JihuiTanUchicago/pcb-for-robot/final_presentation_slides/final presentation.pdf

Youtube: https://youtu.be/oqg4fr0NS5o

## Buzzer

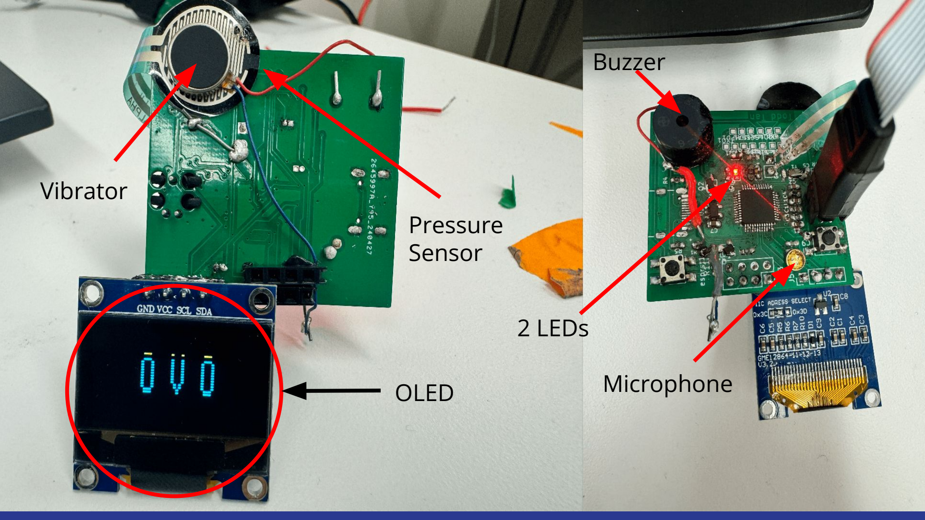
[picture p1: page 2]

## OLED

## Vibrator Pressure Sensor

## Microphone

## 2 LEDs

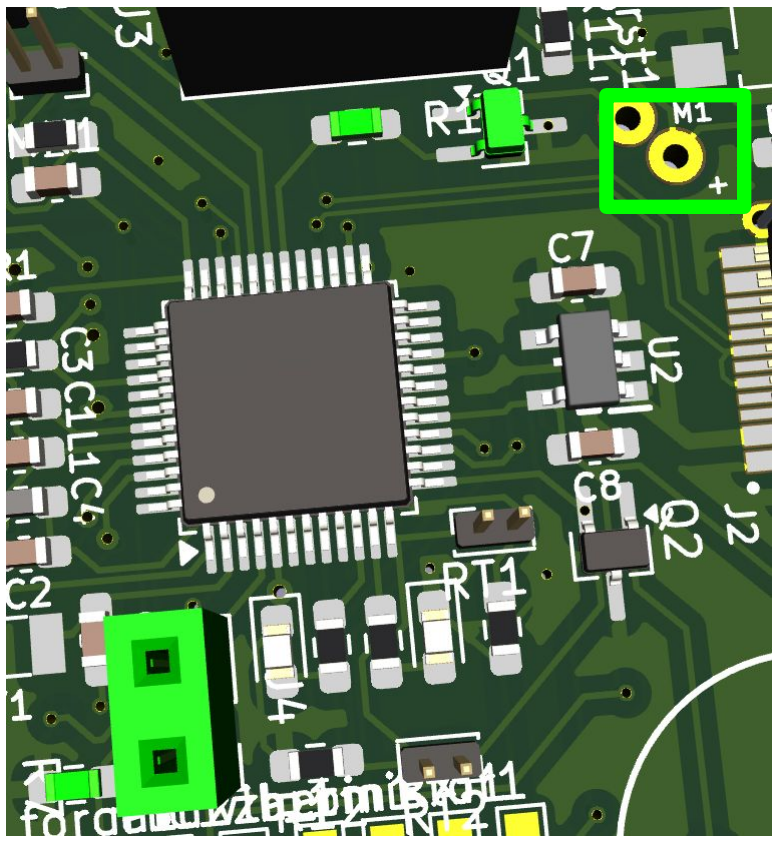
[picture p2: figure]

- Both vibrator and pressure sensor are extendable from the main PCB so that they could be attached together to create haptic feedbacks to the user

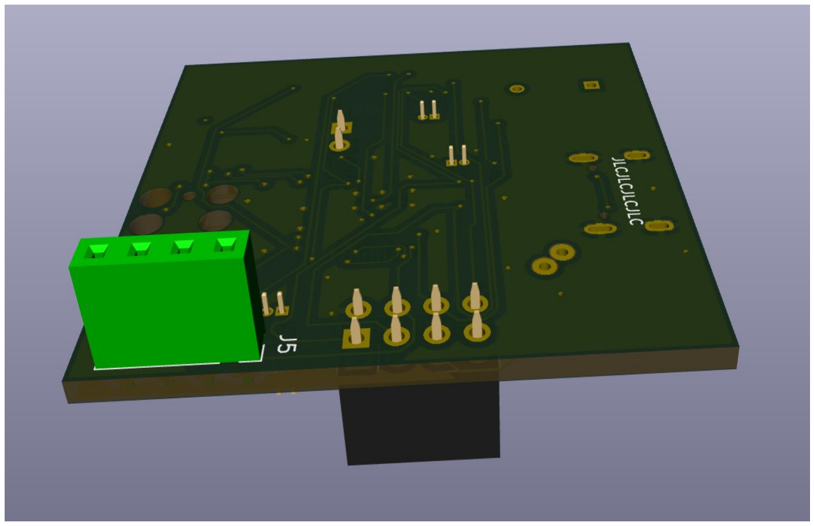
[picture p3: figure]

Other components are on
the back while only OLED
is facing the user

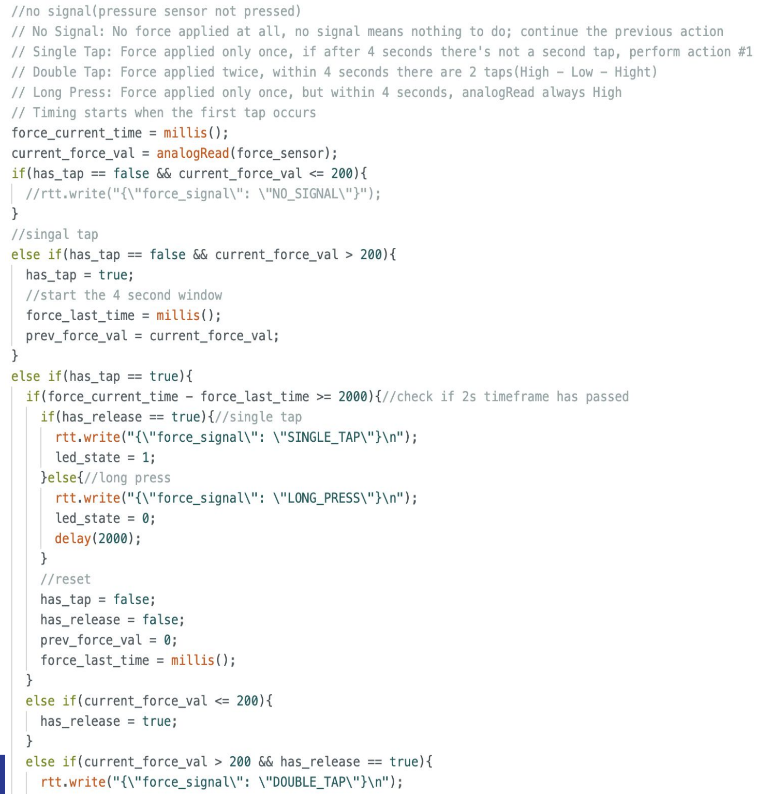
[picture p4: figure]

## Tap, Double Tap, Hold

Start a 2 seconds timer when the first tap(i.e. force sensor reading > 200) is captured

HIGH - LOW - HIGH = “DOUBLE_TAP”

HIGH - LOW = “SINGLE_TAP”

HIGH - HIGH = “LONG_PRESS”

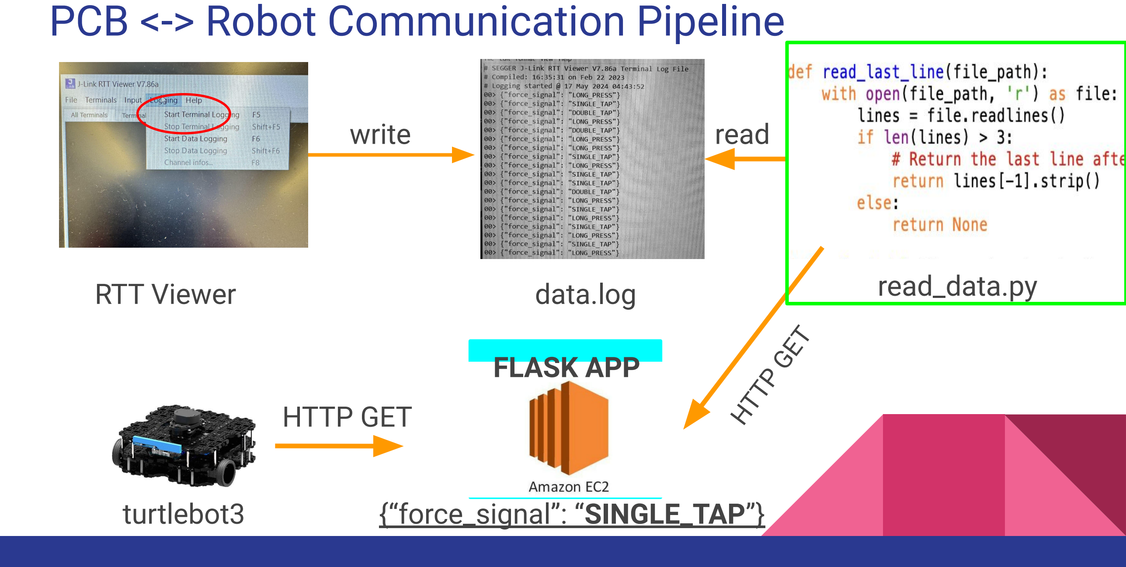
[picture p5: figure]
PCB <-> Robot Communication Pipeline; RTT Viewer; write; data.log; read; read_data.py; HTTP GET; turtlebot3; {“force_signal”: “SINGLE_TAP”}; FLASK APP

## Robot Commander

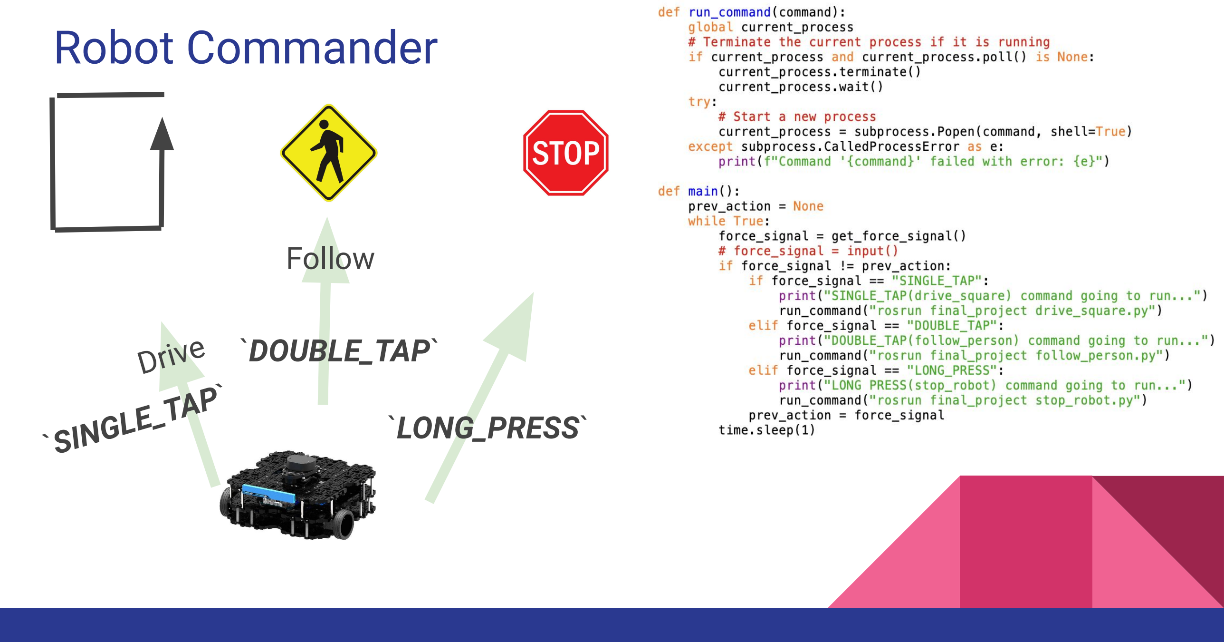
[picture p6: page 7]

Drive
`SINGLE_TAP`

`DOUBLE_TAP`

Follow

`LONG_PRESS`
