JihuiTanUchicago/pcb-for-robot/KiCAD/overview/PCB.png

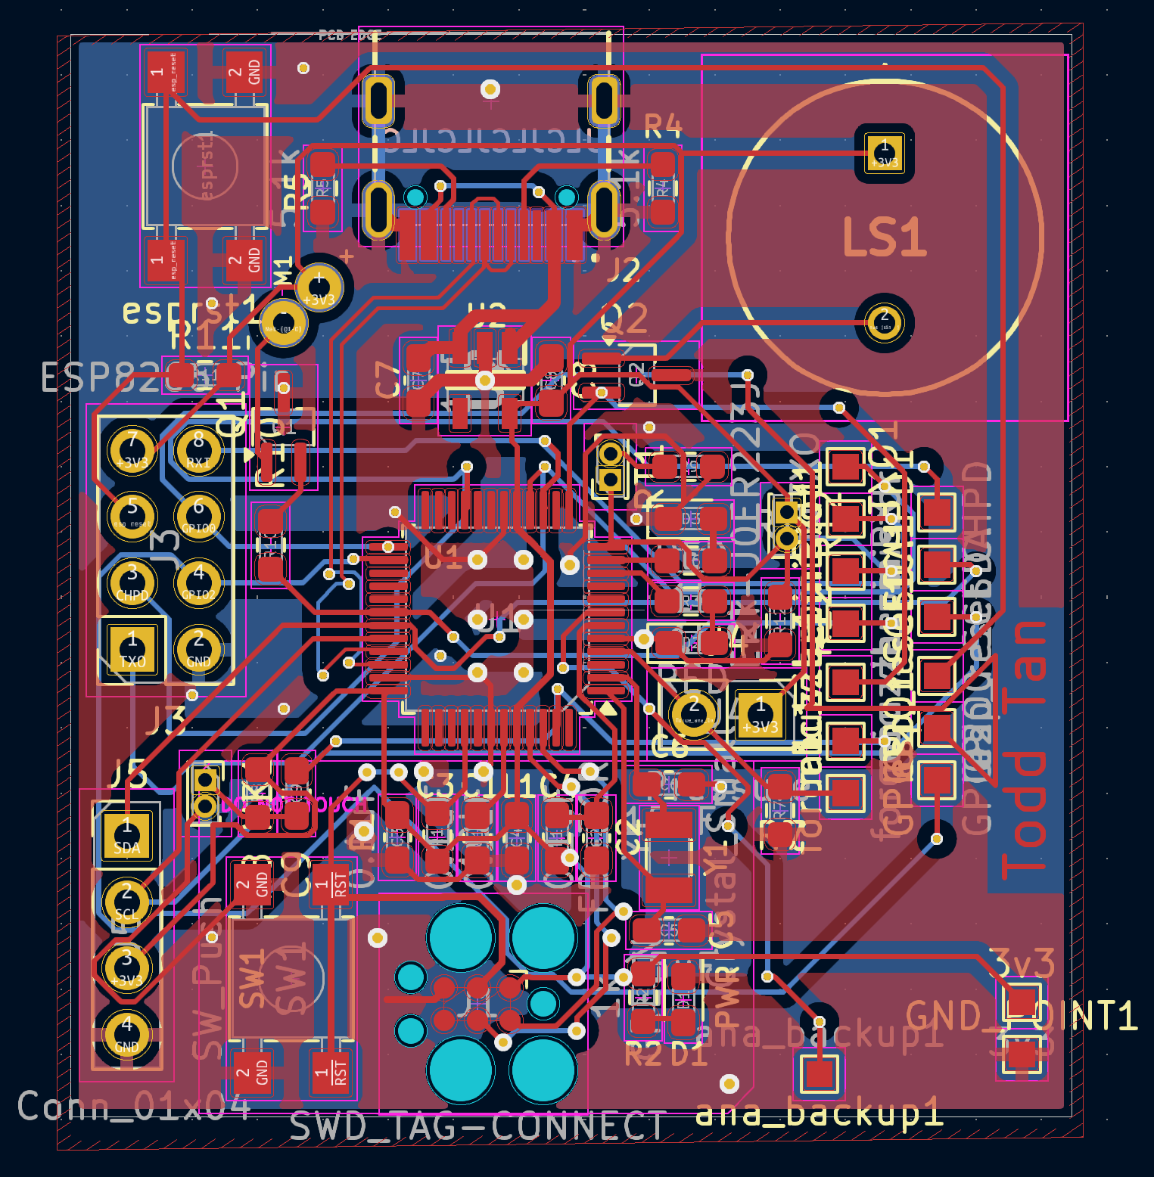
KiCAD/overview/PCB.png
