JihuiTanUchicago/pcb-for-robot/KiCAD/overview/Schematics.png

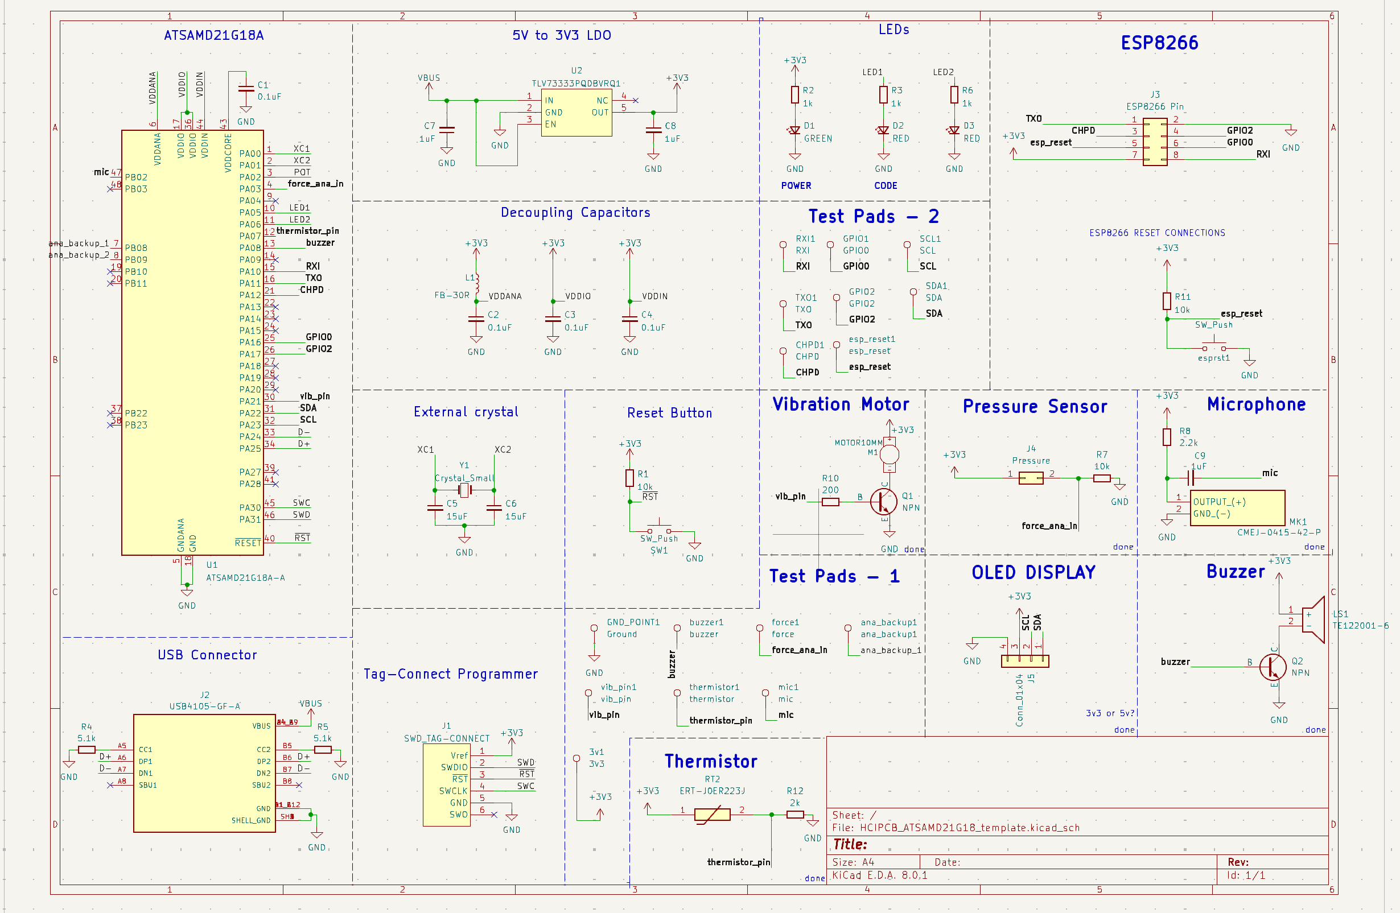
KiCAD/overview/Schematics.png
