JihuiTanUchicago/pcb-for-robot/KiCAD/kicad_files/HCIPCB_ATSAMD21G18_template.kicad_pcb

## KiCad design KiCAD/kicad_files/HCIPCB_ATSAMD21G18_template.kicad_pcb (2024-05-19)

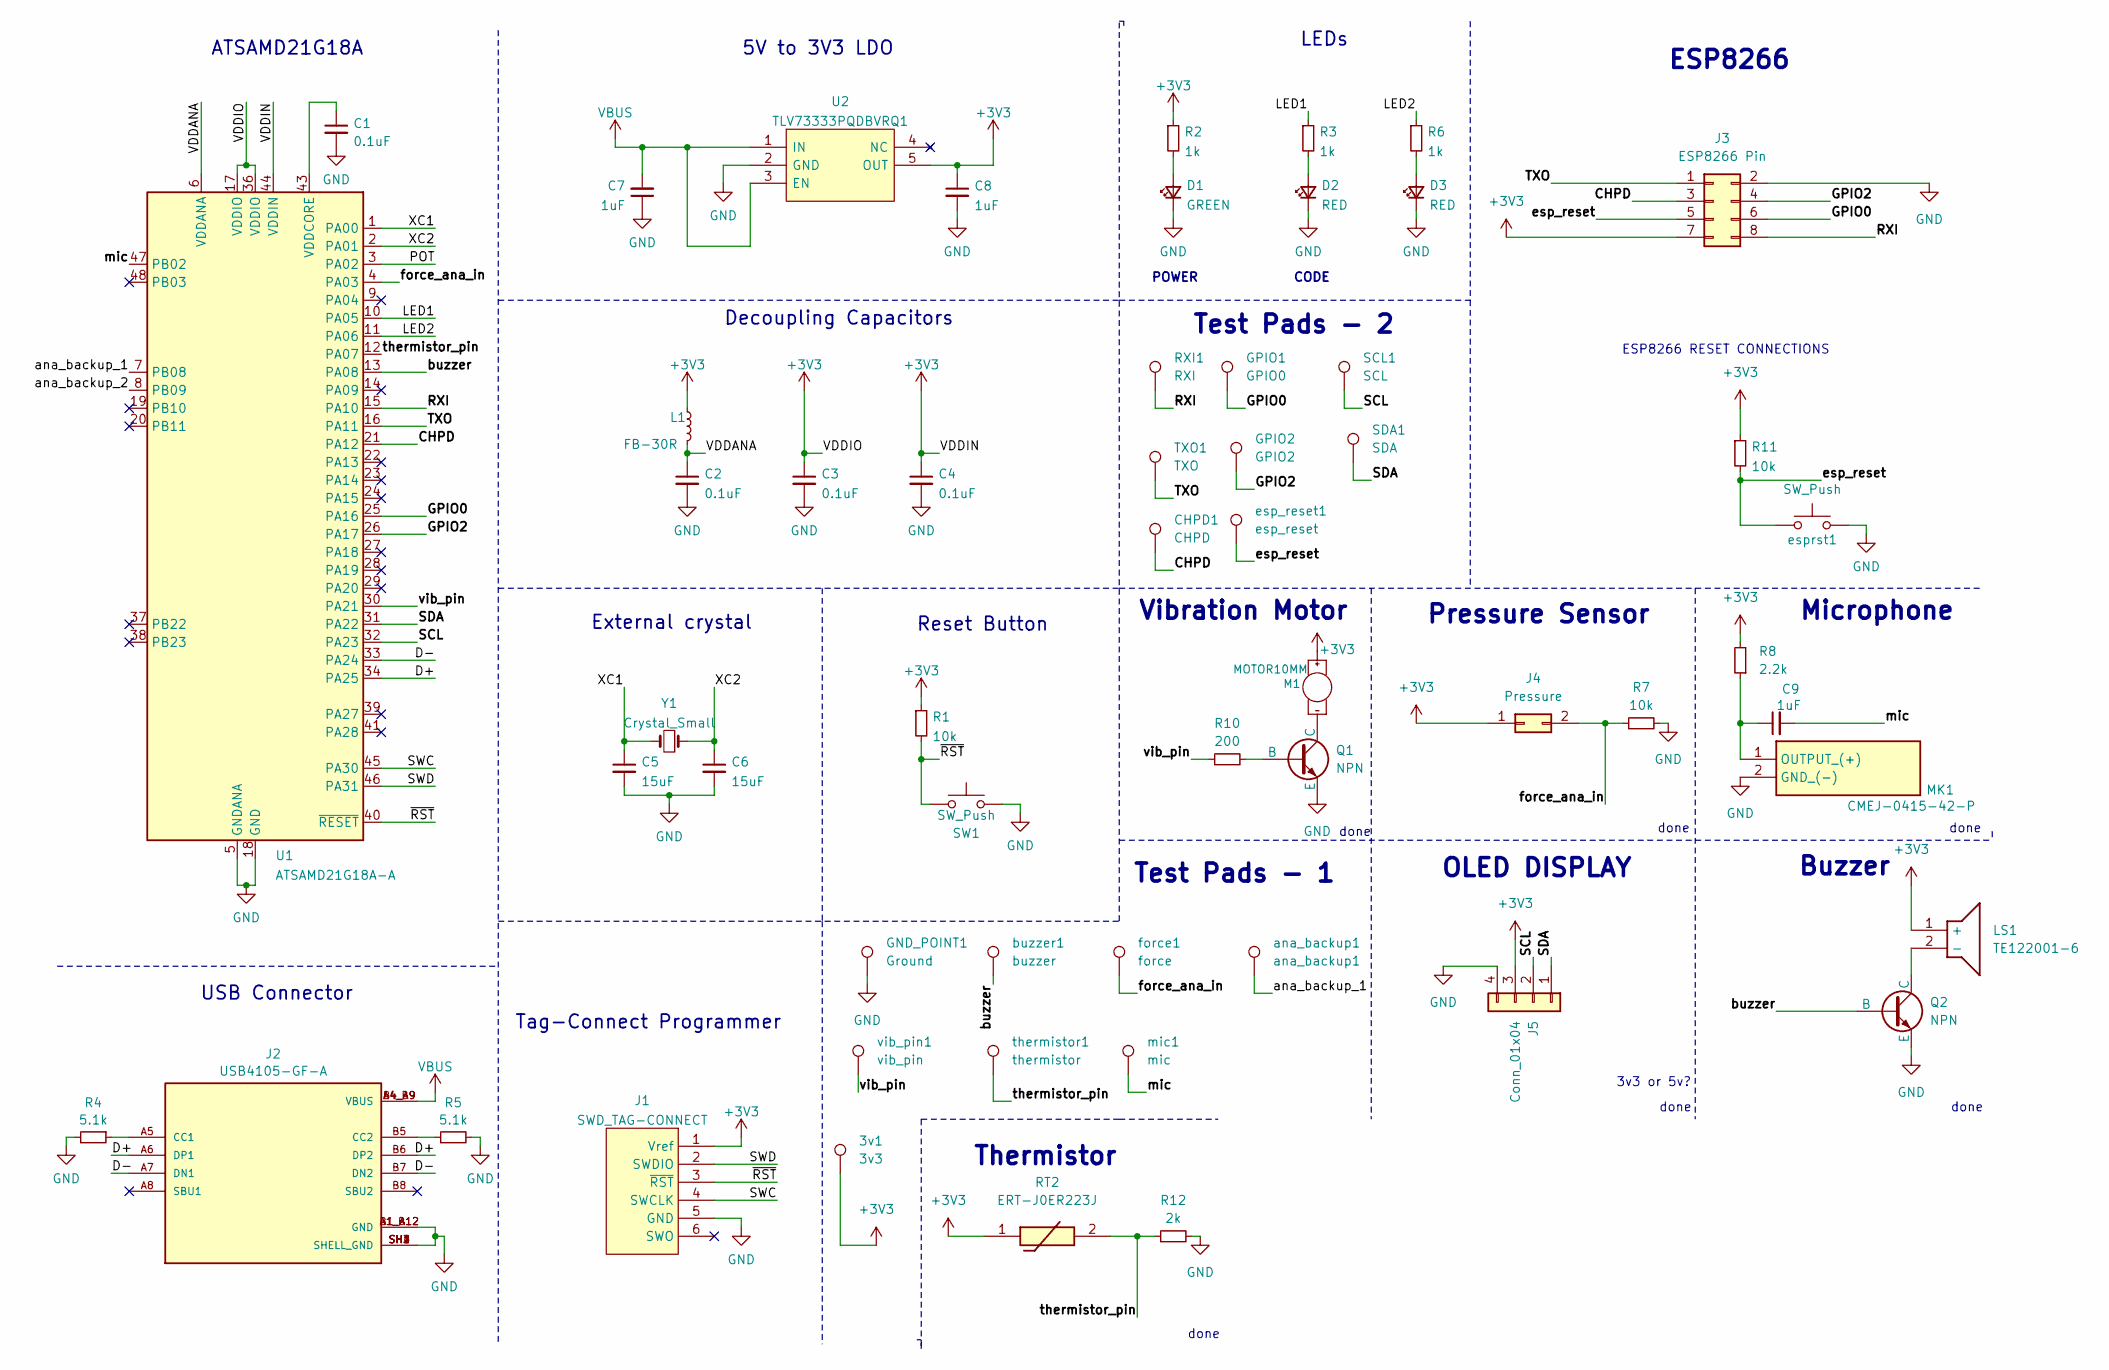
[picture p9: schematic HCIPCB_ATSAMD21G18_template.kicad_sch]

Parts:
3v1: 3v3; TestPoint_Pad_1.0x1.0mm
C1, C2, C3, C4: 0.1uF; C_0603_1608Metric_Pad1.08x0.95mm_HandSolder
C5, C6: 15uF; C_0603_1608Metric_Pad1.08x0.95mm_HandSolder
C7, C8, C9: 1uF; C_0603_1608Metric_Pad1.08x0.95mm_HandSolder
CHPD1: CHPD; TestPoint_Pad_1.0x1.0mm
D1: GREEN; LED_0603_1608Metric_Pad1.05x0.95mm_HandSolder
D2, D3: RED; LED_0603_1608Metric_Pad1.05x0.95mm_HandSolder
GND_POINT1: Ground; TestPoint_Pad_1.0x1.0mm
GPIO1: GPIO0; TestPoint_Pad_1.0x1.0mm
GPIO2: GPIO2; TestPoint_Pad_1.0x1.0mm
J1: SWD_TAG-CONNECT; Tag-Connect_TC2030-IDC-FP_2x03_P1.27mm_Vertical
J2: USB4105-GF-A; GCT_USB4105-GF-A
J3: ESP8266 Pin; PinSocket_2x04_P2.54mm_Vertical
J4: Pressure; PinSocket_2x01_P2.54mm_Vertical
J5: Conn_01x04; PinHeader_1x04_P2.54mm_Vertical
L1: FB-30R; L_0603_1608Metric_Pad1.05x0.95mm_HandSolder
LS1: TE122001-6; TE1220016; Mouser Part Number 497-TE122001-6
M1: MOTOR10MM; VIBE-MOTOR-10MM
MK1: CMEJ-0415-42-P; PinHeader_2x01_P1.00mm_Vertical; Mouser Part Number 490-CMEJ-0415-42-P
Q1, Q2: NPN; SOT-323_SC-70_Handsoldering
R1, R7, R11: 10k; R_0603_1608Metric_Pad0.98x0.95mm_HandSolder
R2, R3, R6: 1k; R_0603_1608Metric_Pad0.98x0.95mm_HandSolder
R4, R5: 5.1k; R_0603_1608Metric_Pad0.98x0.95mm_HandSolder
R8: 2.2k; R_0603_1608Metric_Pad0.98x0.95mm_HandSolder
R10: 200; R_0603_1608Metric_Pad0.98x0.95mm_HandSolder
R12: 2k; R_0603_1608Metric_Pad0.98x0.95mm_HandSolder
RT2: ERT-J0ER223J; PinHeader_2x01_P1.00mm_Vertical; Mouser Part Number 667-ERT-J0ER223J
RXI1: RXI; TestPoint_Pad_1.0x1.0mm
SCL1: SCL; TestPoint_Pad_1.0x1.0mm
SDA1: SDA; TestPoint_Pad_1.0x1.0mm
SW1: SW_Push; SW_SPST_TL3305A
TXO1: TXO; TestPoint_Pad_1.0x1.0mm
U1: ATSAMD21G18A-A; TQFP-48_7x7mm_P0.5mm
U2: TLV73333PQDBVRQ1; SOT95P280X145-5N; Mouser Part Number 595-TLV73333PQDBVRQ1
Y1: Crystal_Small; Crystal_SMD_3215-2Pin_3.2x1.5mm
ana_backup1: ana_backup1; TestPoint_Pad_1.0x1.0mm
buzzer1: buzzer; TestPoint_Pad_1.0x1.0mm
esp_reset1: esp_reset; TestPoint_Pad_1.0x1.0mm
esprst1: SW_Push; SW_SPST_TL3305A
force1: force; TestPoint_Pad_1.0x1.0mm
mic1: mic; TestPoint_Pad_1.0x1.0mm
thermistor1: thermistor; TestPoint_Pad_1.0x1.0mm
vib_pin1: vib_pin; TestPoint_Pad_1.0x1.0mm

Connections:
+3V3: 3v1.1, C3.1, C4.1, C8.1, J1.1 (Vref), J3.7, J4.1, J5.3, L1.1, LS1.1 (+), M1.+, R1.1, R2.1, R8.2, R11.1, RT2.1, U1.17 (VDDIO), U1.36 (VDDIO), U1.44 (VDDIN), U2.5 (OUT); also elsewhere on the board
/CHPD: CHPD1.1, J3.3, U1.21 (PA12)
/D+: J2.A6 (DP1), J2.B6 (DP2), U1.34 (PA25)
/D-: J2.A7 (DN1), J2.B7 (DN2), U1.33 (PA24)
/GPIO0: GPIO1.1, J3.6, U1.25 (PA16)
/GPIO2: GPIO2.1, J3.4, U1.26 (PA17)
/LED1: R3.1, U1.10 (PA05)
/LED2: R6.1, U1.11 (PA06)
/POT: U1.3 (PA02)
/RXI: J3.8, RXI1.1, U1.15 (PA10)
/SCL: J5.2, SCL1.1, U1.32 (PA23)
/SDA: J5.1, SDA1.1, U1.31 (PA22)
/SWC: J1.4 (SWCLK), U1.45 (PA30)
/SWD: J1.2 (SWDIO), U1.46 (PA31)
/TXO: J3.1, TXO1.1, U1.16 (PA11)
/VDDANA: C2.1, L1.2, U1.6 (VDDANA)
/XC1: C5.1, U1.1 (PA00), Y1.2
/XC2: C6.1, U1.2 (PA01), Y1.1
/ana_backup_1: U1.7 (PB08), ana_backup1.1
/ana_backup_2: U1.8 (PB09)
/buzzer: Q2.2 (B), U1.13 (PA08), buzzer1.1
/esp_reset: J3.5, R11.2, esp_reset1.1, esprst1.1
/force_ana_in: J4.2, R7.1, U1.4 (PA03), force1.1
/mic: C9.2, U1.47 (PB02), mic1.1
/thermistor_pin: R12.1, RT2.2, U1.12 (PA07), thermistor1.1; also elsewhere on the board
/vib_pin: R10.1, U1.30 (PA21), vib_pin1.1
/~RST: J1.3 (~RST), R1.2, SW1.1, U1.40 (~RESET)
GND: C1.2, C2.2, C3.2, C4.2, C5.2, C6.2, C7.1, C8.2, D1.1 (K), D2.1 (K), D3.1 (K), GND_POINT1.1, J1.5 (GND), J2.A1_B12 (GND), J2.B1_A12 (GND), J2.SH1 (SHELL_GND), J2.SH2 (SHELL_GND), J2.SH3 (SHELL_GND), J2.SH4 (SHELL_GND), J3.2, J5.4, MK1.2 (GND_(-)), Q1.3 (E), Q2.3 (E), R4.2, R5.2, R7.2, R12.2, SW1.2, U1.5 (GNDANA), U1.18 (GND), U1.35 (GND), U1.42 (GND), U2.2 (GND), esprst1.2; also elsewhere on the board
unnamed: D1.2 (A), R2.2
unnamed: D2.2 (A), R3.2
unnamed: D3.2 (A), R6.2
unnamed: J2.A5 (CC1), R4.1
unnamed: J2.B5 (CC2), R5.1
unnamed: LS1.2 (-), Q2.1 (C)
unnamed: C9.1, MK1.1 (OUTPUT_(+)), R8.1
unnamed: Q1.2 (B), R10.2
unnamed: M1.-, Q1.1 (C)
unnamed: C1.1, U1.43 (VDDCORE)
VBUS: C7.2, J2.A4_B9 (VBUS), J2.B4_A9 (VBUS), U2.1 (IN), U2.3 (EN)

Notes on the sheet:
5V to 3V3 LDO
3v3 or 5v?
External crystal
OLED DISPLAY
Thermistor
Test Pads - 2
Tag-Connect Programmer
Decoupling Capacitors
done
ESP8266 RESET CONNECTIONS
CODE
Test Pads - 1
Microphone
Buzzer
LEDs
Pressure Sensor
POWER
ESP8266
Vibration Motor
USB Connector
ATSAMD21G18A
Reset Button

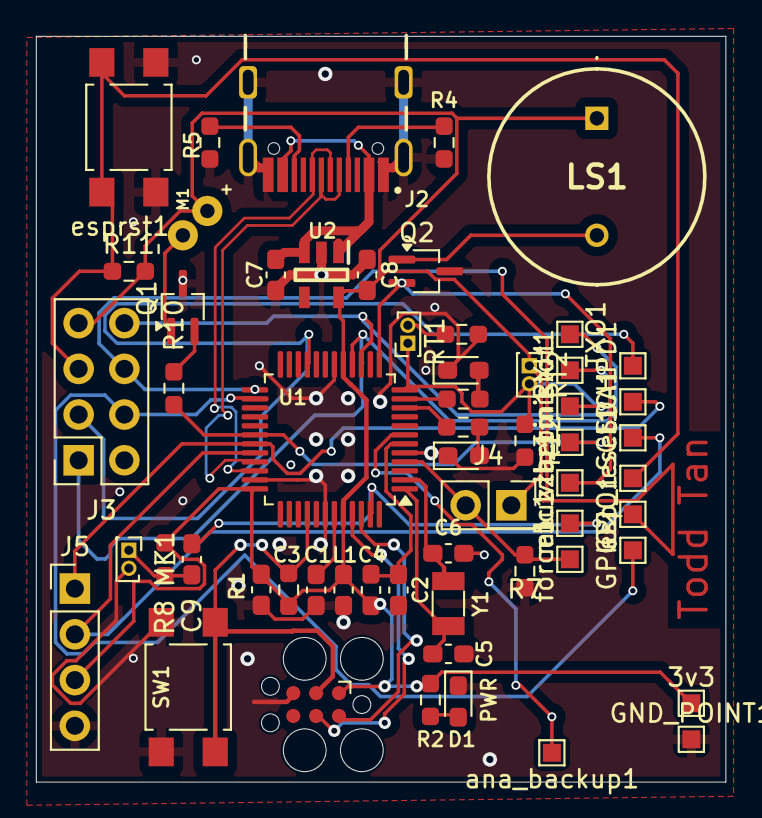
[picture p10: board HCIPCB_ATSAMD21G18_template.kicad_pcb from above]

Board: 2 copper layers, 38.3 x 41.4 mm, 58 parts (0 on the bottom side), 38 nets.

Other parts of the board:
3v3: 3v3; TestPoint_Pad_1.0x1.0mm
R9: 750; R_0603_1608Metric_Pad0.98x0.95mm_HandSolder
RT1: ERT-J0ER223J; PinHeader_2x01_P1.00mm_Vertical

Their connections:
+3V3: 3v3.1; also elsewhere on the board
/thermistor_pin: RT1.1; also elsewhere on the board
GND: R9.2; also elsewhere on the board
unnamed: R9.1, RT1.2
